bastinat0r/DWM-1000-Adapter-board/README.md

# Board to Interface with DWM1000 module from Decawave

Created by Sebastian Mai under CC-BY-SA 2.0 license.
