bastinat0r/DWM-1000-Adapter-board/Decawave.kicad_pcb

## KiCad design Decawave.kicad_pcb (2018-05-14)

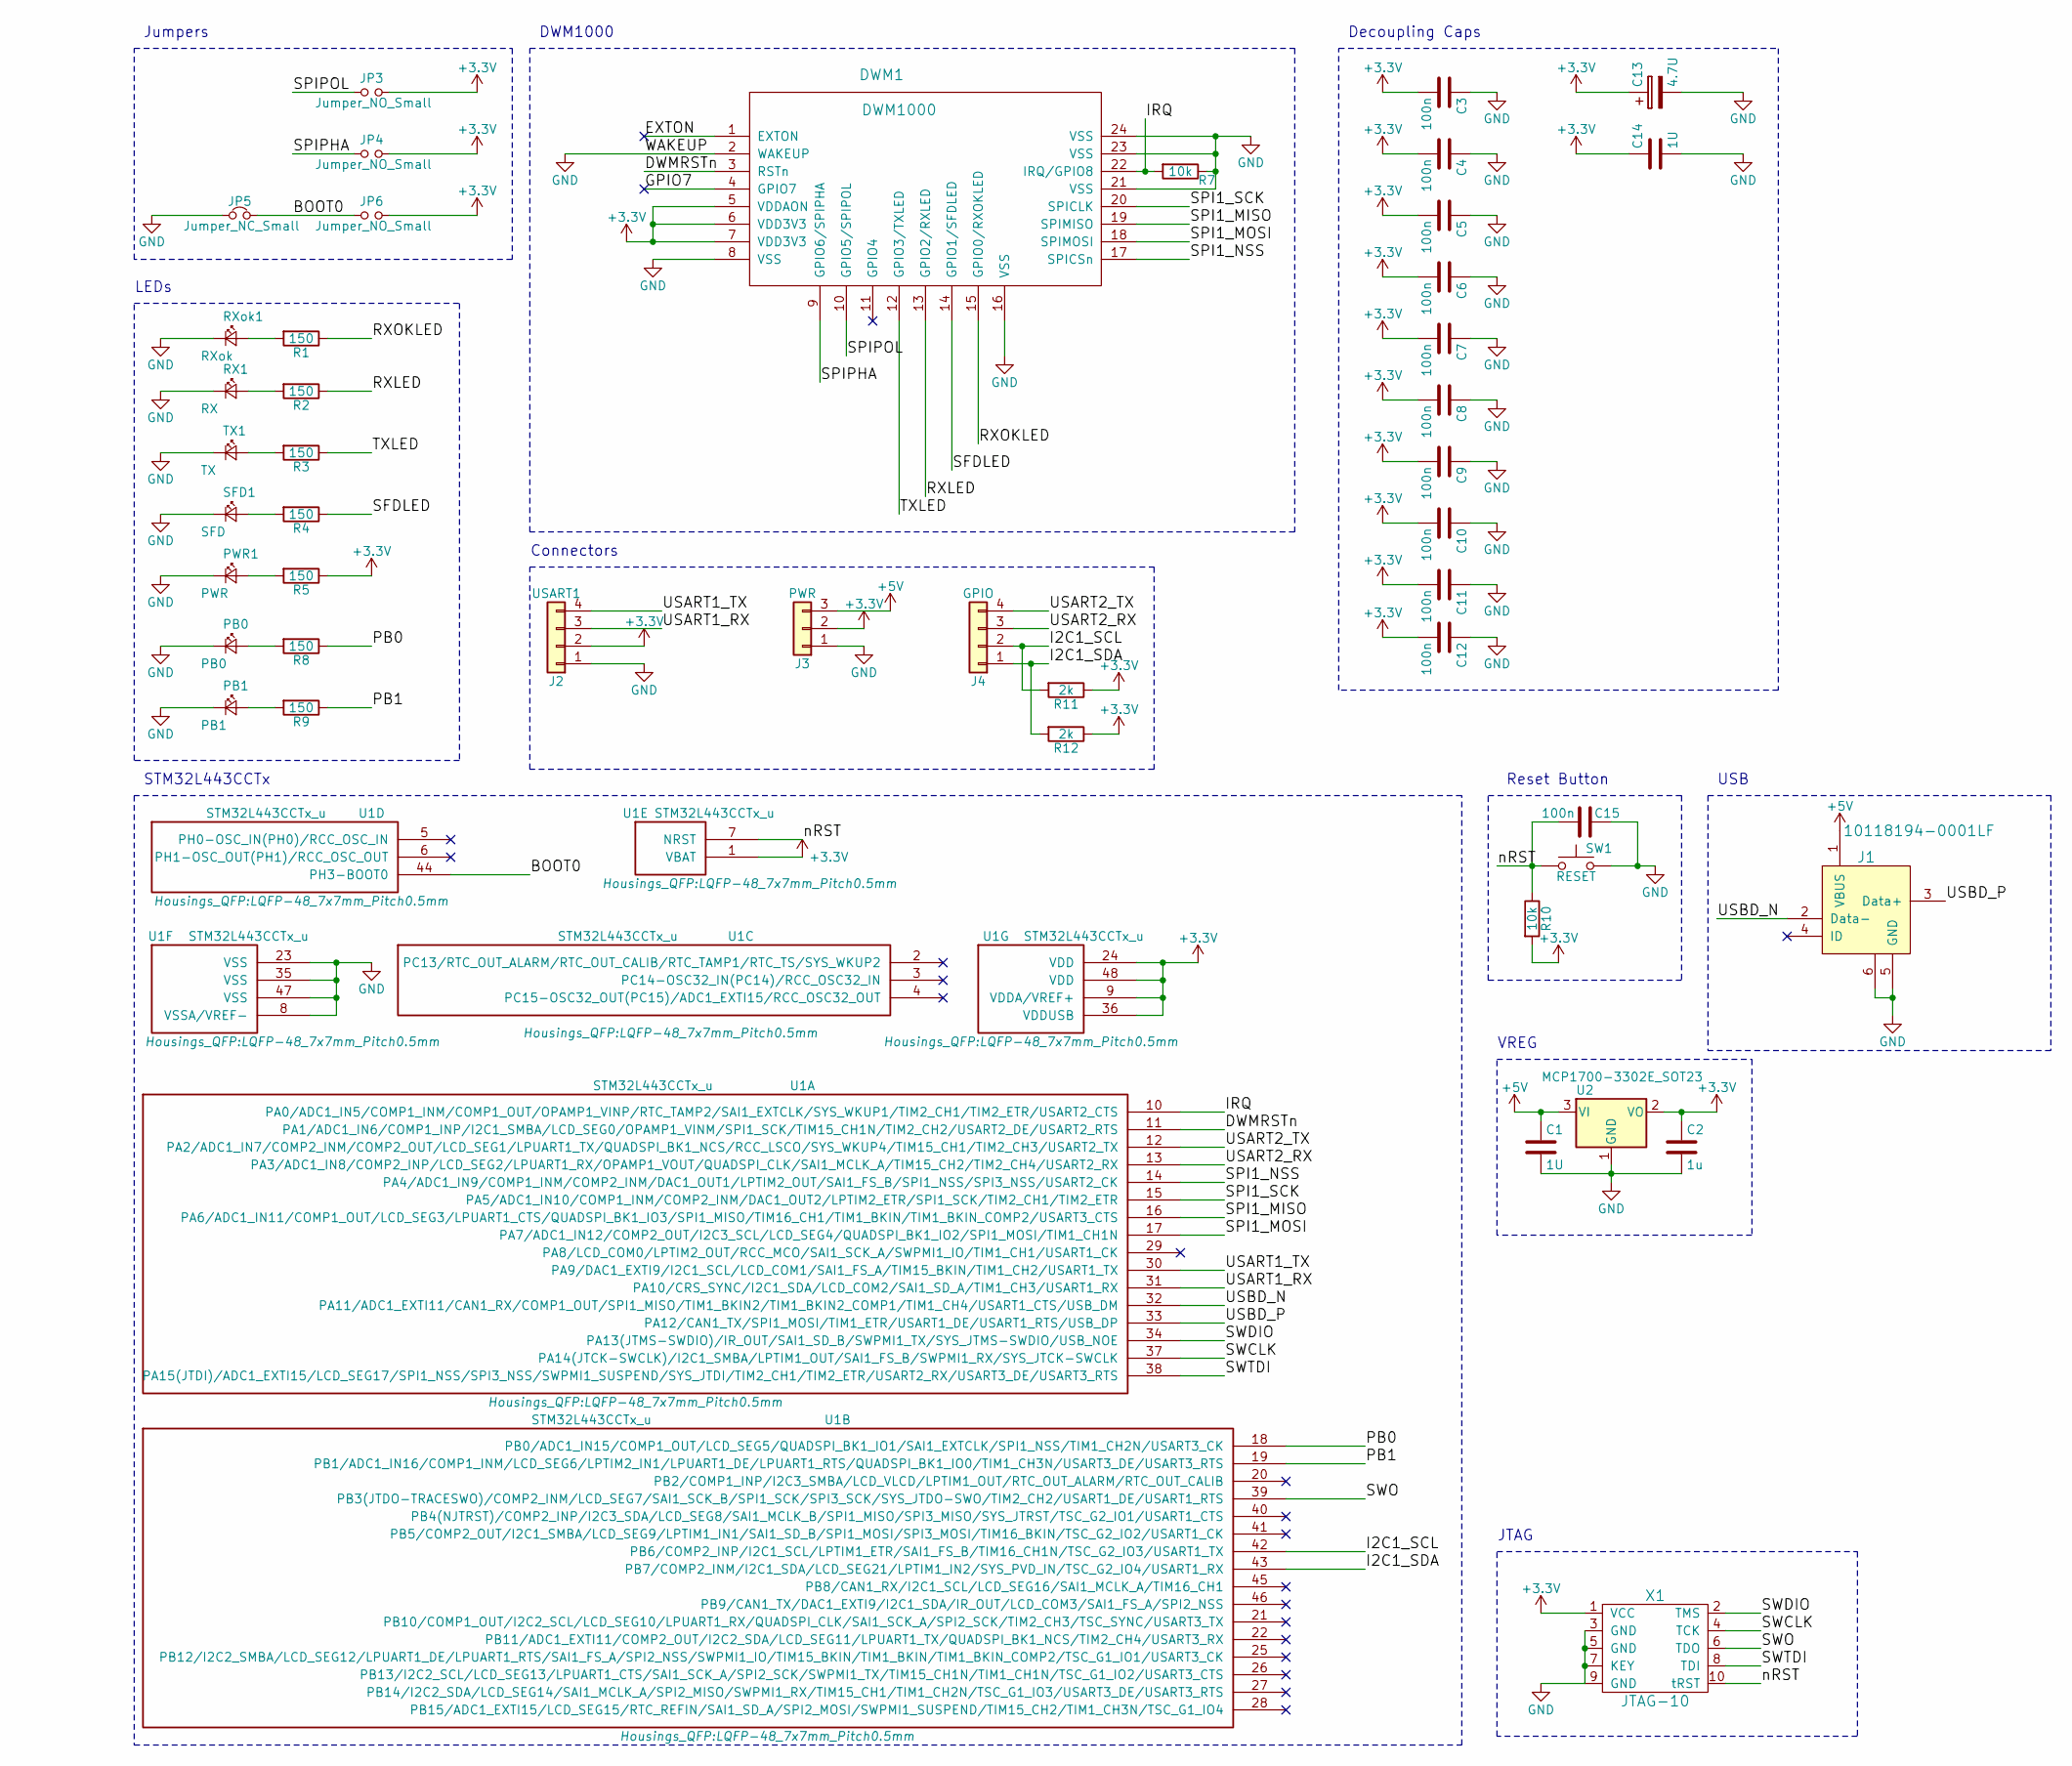
[picture p1: schematic Decawave.sch, DWM1000 Adapter Board]

Parts:
C1, C14: 1U; C_1206_HandSoldering
C2: 1u; C_1206_HandSoldering
C3, C4, C5, C6, C7, C8, C9, C10, C11, C12, C15: 100n; C_0603_HandSoldering
C13: 4.7U; CP_Tantalum_Case-A_EIA-3216-18_Hand
DWM1: DWM1000
J1: 10118194-0001LF; USB_Micro_B_Female_10118194-0001LF; MPN 10118194-0001LF; Digi-Key_PN 609-4618-1-ND
J2: USART1; Pin_Header_Straight_1x04_Pitch2.54mm
J3: PWR; Pin_Header_Straight_1x03_Pitch2.54mm
J4: GPIO; Pin_Header_Straight_1x04_Pitch2.54mm
JP3, JP4, JP6: Jumper_NO_Small; R_0402
JP5: Jumper_NC_Small; R_0402
PB0: PB0; LED_0805_HandSoldering
PB1: PB1; LED_0805_HandSoldering
PWR1: PWR; LED_0805_HandSoldering
R1, R2, R3, R4, R5, R8, R9: 150; R_0603_HandSoldering
R7, R10: 10k; R_0603_HandSoldering
R11, R12: 2k; R_0603_HandSoldering
RX1: RX; LED_0805_HandSoldering
RXok1: RXok; LED_0805_HandSoldering
SFD1: SFD; LED_0805_HandSoldering
SW1: RESET; SW_SPST_TL3342
TX1: TX; LED_0805_HandSoldering
U1: STM32L443CCTx_u; LQFP-48_7x7mm_Pitch0.5mm
U2: MCP1700-3302E_SOT23; SOT-23_Handsoldering
X1: JTAG-10; FTSH-105-XX-X-DV

Connections:
+3V3: C2.1, C3.2, C4.2, C5.2, C6.2, C7.2, C8.2, C9.2, C10.2, C11.2, C12.2, C13.1, C14.1, DWM1.5 (VDDAON), DWM1.6 (VDD3V3), DWM1.7 (VDD3V3), J2.2, J3.2, JP3.2, JP4.2, JP6.2, R5.1, R10.2, R11.1, R12.1, U1.1 (VBAT), U1.9 (VDDA/VREF+), U1.24 (VDD), U1.36 (VDDUSB), U1.48 (VDD), U2.2 (VO), X1.1 (VCC)
+5V: C1.1, J1.1 (VBUS), J3.3, U2.3 (VI)
/BOOT0: JP5.2, JP6.1, U1.44 (PH3-BOOT0)
/DWMRSTn: DWM1.3 (RSTn), U1.11 (PA1/ADC1_IN6/COMP1_INP/I2C1_SMBA/LCD_SE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)
/EXTON: DWM1.1 (EXTON)
/GPIO7: DWM1.4 (GPIO7)
/I2C1_SCL: J4.2, R11.2, U1.42 (PB6/COMP2_INP/I2C1_SCL/LPTIM1_ETR/SAI1_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)
/I2C1_SDA: J4.1, R12.2, U1.43 (PB7/COMP2_INM/I2C1_SDA/LCD_SEG21/LPTIM1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)
/IRQ: DWM1.22 (IRQ/GPIO8), R7.2, U1.10 (PA0/ADC1_IN5/COMP1_INM/COMP1_OUT/OPAMP1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)
/PB0: R8.1, U1.18 (PB0/ADC1_IN15/COMP1_OUT/LCD_SEG5/QUADSP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)
/PB1: R9.1, U1.19 (PB1/ADC1_IN16/COMP1_INM/LCD_SEG6/LPTIM2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)
/RXLED: DWM1.13 (GPIO2/RXLED), R2.1
/RXOKLED: DWM1.15 (GPIO0/RXOKLED), R1.1
/SFDLED: DWM1.14 (GPIO1/SFDLED), R4.1
/SPI1_MISO: DWM1.19 (SPIMISO), U1.16 (PA6/ADC1_IN11/COMP1_OUT/LCD_SEG3/LPUART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)
/SPI1_MOSI: DWM1.18 (SPIMOSI), U1.17 (PA7/ADC1_IN12/COMP2_OUT/I2C3_SCL/LCD_SE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)
/SPI1_NSS: DWM1.17 (SPICSn), U1.14 (PA4/ADC1_IN9/COMP1_INM/COMP2_INM/DAC1_O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)
/SPI1_SCK: DWM1.20 (SPICLK), U1.15 (PA5/ADC1_IN10/COMP1_INM/COMP2_INM/DAC1_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)
/SPIPHA: DWM1.9 (GPIO6/SPIPHA), JP4.1
/SPIPOL: DWM1.10 (GPIO5/SPIPOL), JP3.1
/SWCLK: U1.37 (PA14(JTCK-SWCLK)/I2C1_SMBA/LPTIM1_OUT/S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), X1.4 (TCK)
/SWDIO: U1.34 (PA13(JTMS-SWDIO)/IR_OUT/SAI1_SD_B/SWPMI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), X1.2 (TMS)
/SWO: U1.39 (PB3(JTDO-TRACESWO)/COMP2_INM/LCD_SEG7/S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), X1.6 (TDO)
/SWTDI: U1.38 (PA15(JTDI)/ADC1_EXTI15/LCD_SEG17/SPI1_N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), X1.8 (TDI)
/TXLED: DWM1.12 (GPIO3/TXLED), R3.1
/USART1_RX: J2.3, U1.31 (PA10/CRS_SYNC/I2C1_SDA/LCD_COM2/SAI1_SD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)
/USART1_TX: J2.4, U1.30 (PA9/DAC1_EXTI9/I2C1_SCL/LCD_COM1/SAI1_F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)
/USART2_RX: J4.3, U1.13 (PA3/ADC1_IN8/COMP2_INP/LCD_SEG2/LPUART1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)
/USART2_TX: J4.4, U1.12 (PA2/ADC1_IN7/COMP2_INM/COMP2_OUT/LCD_SE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)
/USBD_N: J1.2 (Data-), U1.32 (PA11/ADC1_EXTI11/CAN1_RX/COMP1_OUT/SPI1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)
/USBD_P: J1.3 (Data+), U1.33 (PA12/CAN1_TX/SPI1_MOSI/TIM1_ETR/USART1_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)
/nRST: C15.2, R10.1, SW1.1, U1.7 (NRST), X1.10 (tRST)
GND: C1.2, C2.2, C3.1, C4.1, C5.1, C6.1, C7.1, C8.1, C9.1, C10.1, C11.1, C12.1, C13.2, C14.2, C15.1, DWM1.2 (WAKEUP), DWM1.8 (VSS), DWM1.16 (VSS), DWM1.21 (VSS), DWM1.23 (VSS), DWM1.24 (VSS), J1.5 (GND), J1.6, J2.1, J3.1, JP5.1, PB0.1 (K), PB1.1 (K), PWR1.1 (K), R7.1, RX1.1 (K), RXok1.1 (K), SFD1.1 (K), SW1.2, TX1.1 (K), U1.8 (VSSA/VREF-), U1.23 (VSS), U1.35 (VSS), U1.47 (VSS), U2.1 (GND), X1.3 (GND), X1.5 (GND), X1.7 (KEY), X1.9 (GND)
unnamed: PB0.2 (A), R8.2
unnamed: PB1.2 (A), R9.2
unnamed: PWR1.2 (A), R5.2
unnamed: R1.2, RXok1.2 (A)
unnamed: R2.2, RX1.2 (A)
unnamed: R3.2, TX1.2 (A)
unnamed: R4.2, SFD1.2 (A)

Notes on the sheet:
Jumpers
LEDs
JTAG
Reset Button
USB
VREG
Connectors
DWM1000
Decoupling Caps
STM32L443CCTx

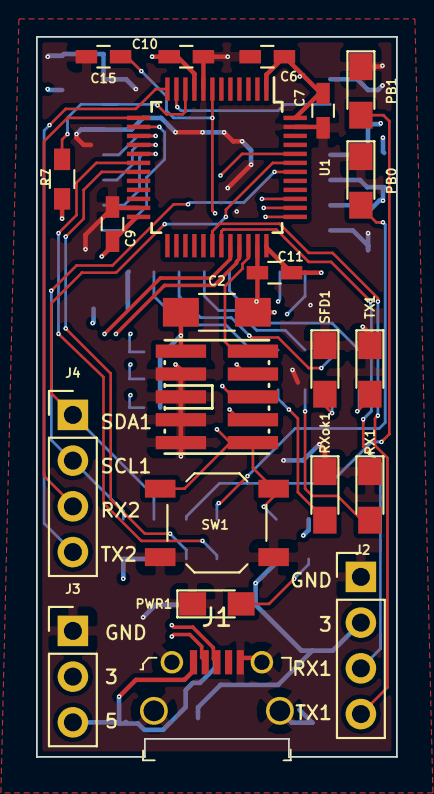
[picture p2: board Decawave.kicad_pcb from above]

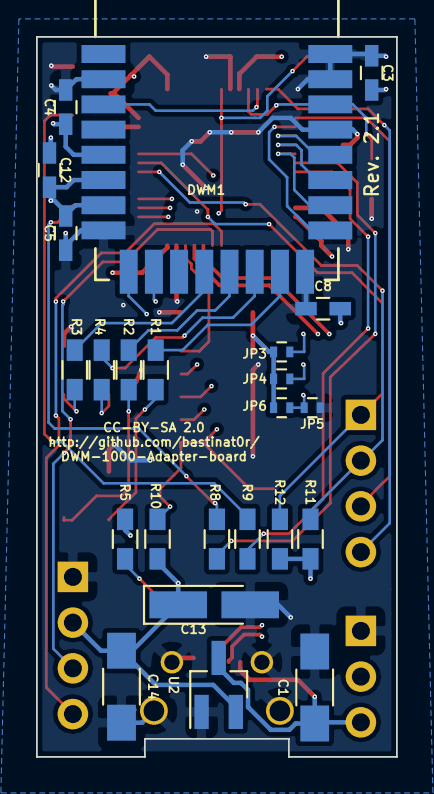
[picture p3: board Decawave.kicad_pcb from below]

Board: 4 copper layers, 20.0 x 40.0 mm, 46 parts (24 on the bottom side), 38 nets.
