bastinat0r/DWM-1000-Adapter-board/(threads)

Thread 1 (2017-11-16):

USB-Footprint does not match the part

bastinat0r, 2017-11-16:
The pins of the two outer things were on the wrong places and had to be bent inwards.
