bastinat0r/DWM-1000-Adapter-board/(commit log)

2017-10-17 inital commit
    [Decawave.kicad_pcb, Decawave.sch]
2017-10-17 adding 100n Cap for nRST
    [Decawave.kicad_pcb, Decawave.sch]
2017-10-17 Reorganising Schematic
    [Decawave.sch]
2017-10-17 add url to gh repo on pcb
    [Decawave.kicad_pcb]
2017-10-18 Some ground-plane improvements
    [Decawave.kicad_pcb]
2017-10-18 even more gnd plane improvements
    [Decawave.kicad_pcb]
2017-10-18 remove unecessary jumpers
    * spipol and spipha are internally pulled low by the DWM1000
    [Decawave.kicad_pcb, Decawave.sch]
2017-10-18 moving usb port closer to the edge
    [Decawave.kicad_pcb]
2017-10-31 fixing text for print-out assembly instructions
    [Decawave.kicad_pcb]
2017-11-15 Moving trace away from the edge of the board
    [Decawave.kicad_pcb]
2018-03-15 usb footprint, route usb as differential pair
    [Decawave.kicad_pcb, Decawave.sch]
2018-05-02 adding silkscreen for pins
    [Decawave.kicad_pcb]
2018-05-14 adding more space for usb connector
    [Decawave.kicad_pcb]
2018-05-14 adding modified micro usb (slots -> holes)
